plex1/SpinalDevTofProject/fw/hdl/src/main/verilog/DelayLine.v

//automatically created by CreateDelineLineVerilog.scala
(* keep *)
module DelayLine #(parameter num_elements = 128) (
    input clk,
    input in_signal,
    input a, // a needs to be set to 1
    input b, // b needs to be set to 0
    output [num_elements-1:0]delay_value);

    wire [num_elements-1:0] x;
    wire [num_elements-1:0] y;
    wire [num_elements-1:0] z;
    assign x[0] = in_signal;

    (* keep="true"  *)
    (* BEL="X2/Y1/lc0" *)
    SB_LUT4 #(.LUT_INIT(1)) lut_i0(.I0(x[0]), .I1(), .I2(), .I3(), .O(x[1]));
    assign y[1] = x[1];

    (* keep="true"  *)
    (* BEL="X3/Y1/lc0" *)
    SB_DFF reg_i0(.Q(z[1]), .C(clk), .D(y[1]));


    (* keep="true"  *)
    (* BEL="X2/Y1/lc1" *)
    SB_LUT4 #(.LUT_INIT(1)) lut_i1(.I0(x[1]), .I1(), .I2(), .I3(), .O(x[2]));
    assign y[2] = x[2];

    (* keep="true"  *)
    (* BEL="X3/Y1/lc1" *)
    SB_DFF reg_i1(.Q(z[2]), .C(clk), .D(y[2]));


    (* keep="true"  *)
    (* BEL="X2/Y1/lc2" *)
    SB_LUT4 #(.LUT_INIT(1)) lut_i2(.I0(x[2]), .I1(), .I2(), .I3(), .O(x[3]));
    assign y[3] = x[3];

    (* keep="true"  *)
    (* BEL="X3/Y1/lc2" *)
    SB_DFF reg_i2(.Q(z[3]), .C(clk), .D(y[3]));


    (* keep="true"  *)
    (* BEL="X2/Y1/lc3" *)
    SB_LUT4 #(.LUT_INIT(1)) lut_i3(.I0(x[3]), .I1(), .I2(), .I3(), .O(x[4]));
    assign y[4] = x[4];

    (* keep="true"  *)
    (* BEL="X3/Y1/lc3" *)
    SB_DFF reg_i3(.Q(z[4]), .C(clk), .D(y[4]));


    (* keep="true"  *)
    (* BEL="X2/Y1/lc4" *)
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
    assign y[127] = x[127];

    (* keep="true"  *)
    (* BEL="X3/Y16/lc6" *)
    SB_DFF reg_i126(.Q(z[127]), .C(clk), .D(y[127]));



    assign y[0] = x[0];
    assign z[0] = y[0];
    assign delay_value = z;

endmodule
