plex1/SpinalDevTofProject/(commit log)

2018-01-22 Updated files while testing with fpga development boards
2018-11-20 added feature to read and write registers via uart
2020-01-14 added sequencer, bugfix in TriggerFinder
    [toplevel.pcf, toplevel.v]
